trueserve/reflowOvenController/hardware/doc/ZC-schema.gif

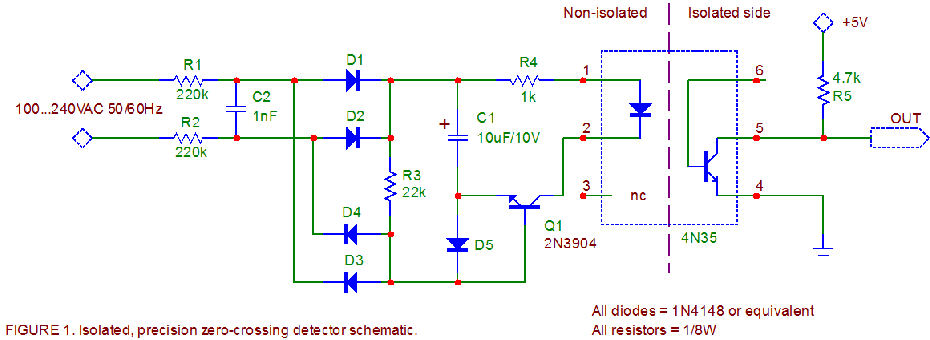
hardware/doc/ZC-schema.gif
