trueserve/reflowOvenController/hardware/ReflowController_kp.v0.2.brd.preview.png

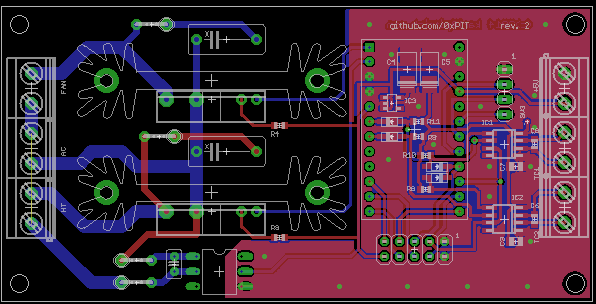
hardware/ReflowController_kp.v0.2.brd.preview.png
