trueserve/reflowOvenController/hardware/ReflowController_kp.v0.2.sch.preview.png

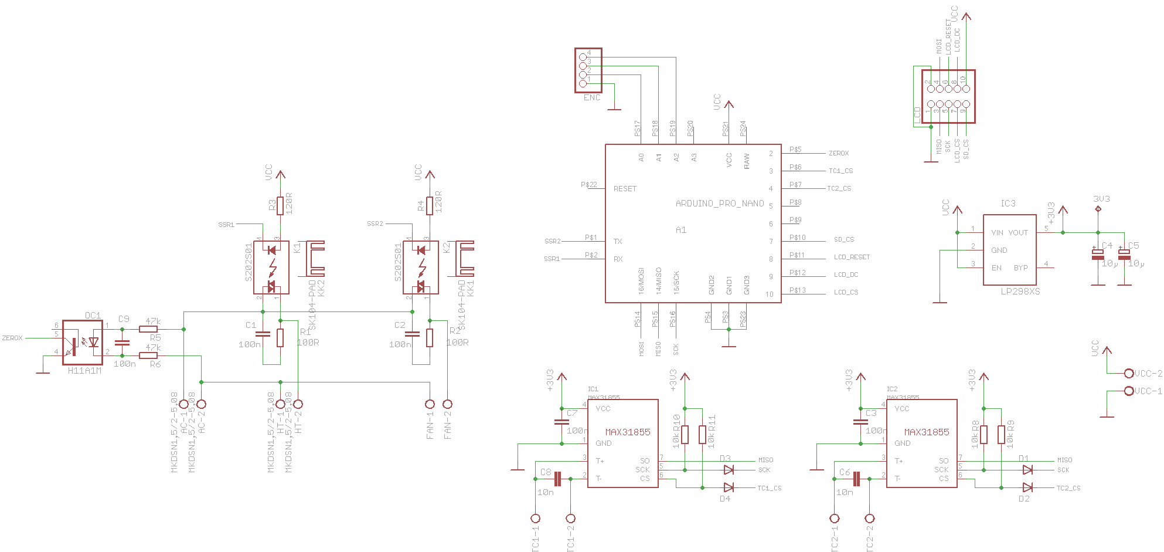
hardware/ReflowController_kp.v0.2.sch.preview.png
