trueserve/reflowOvenController/hardware/ReflowController_kp.brd

## EAGLE design hardware/ReflowController_kp.brd (2014-10-26)

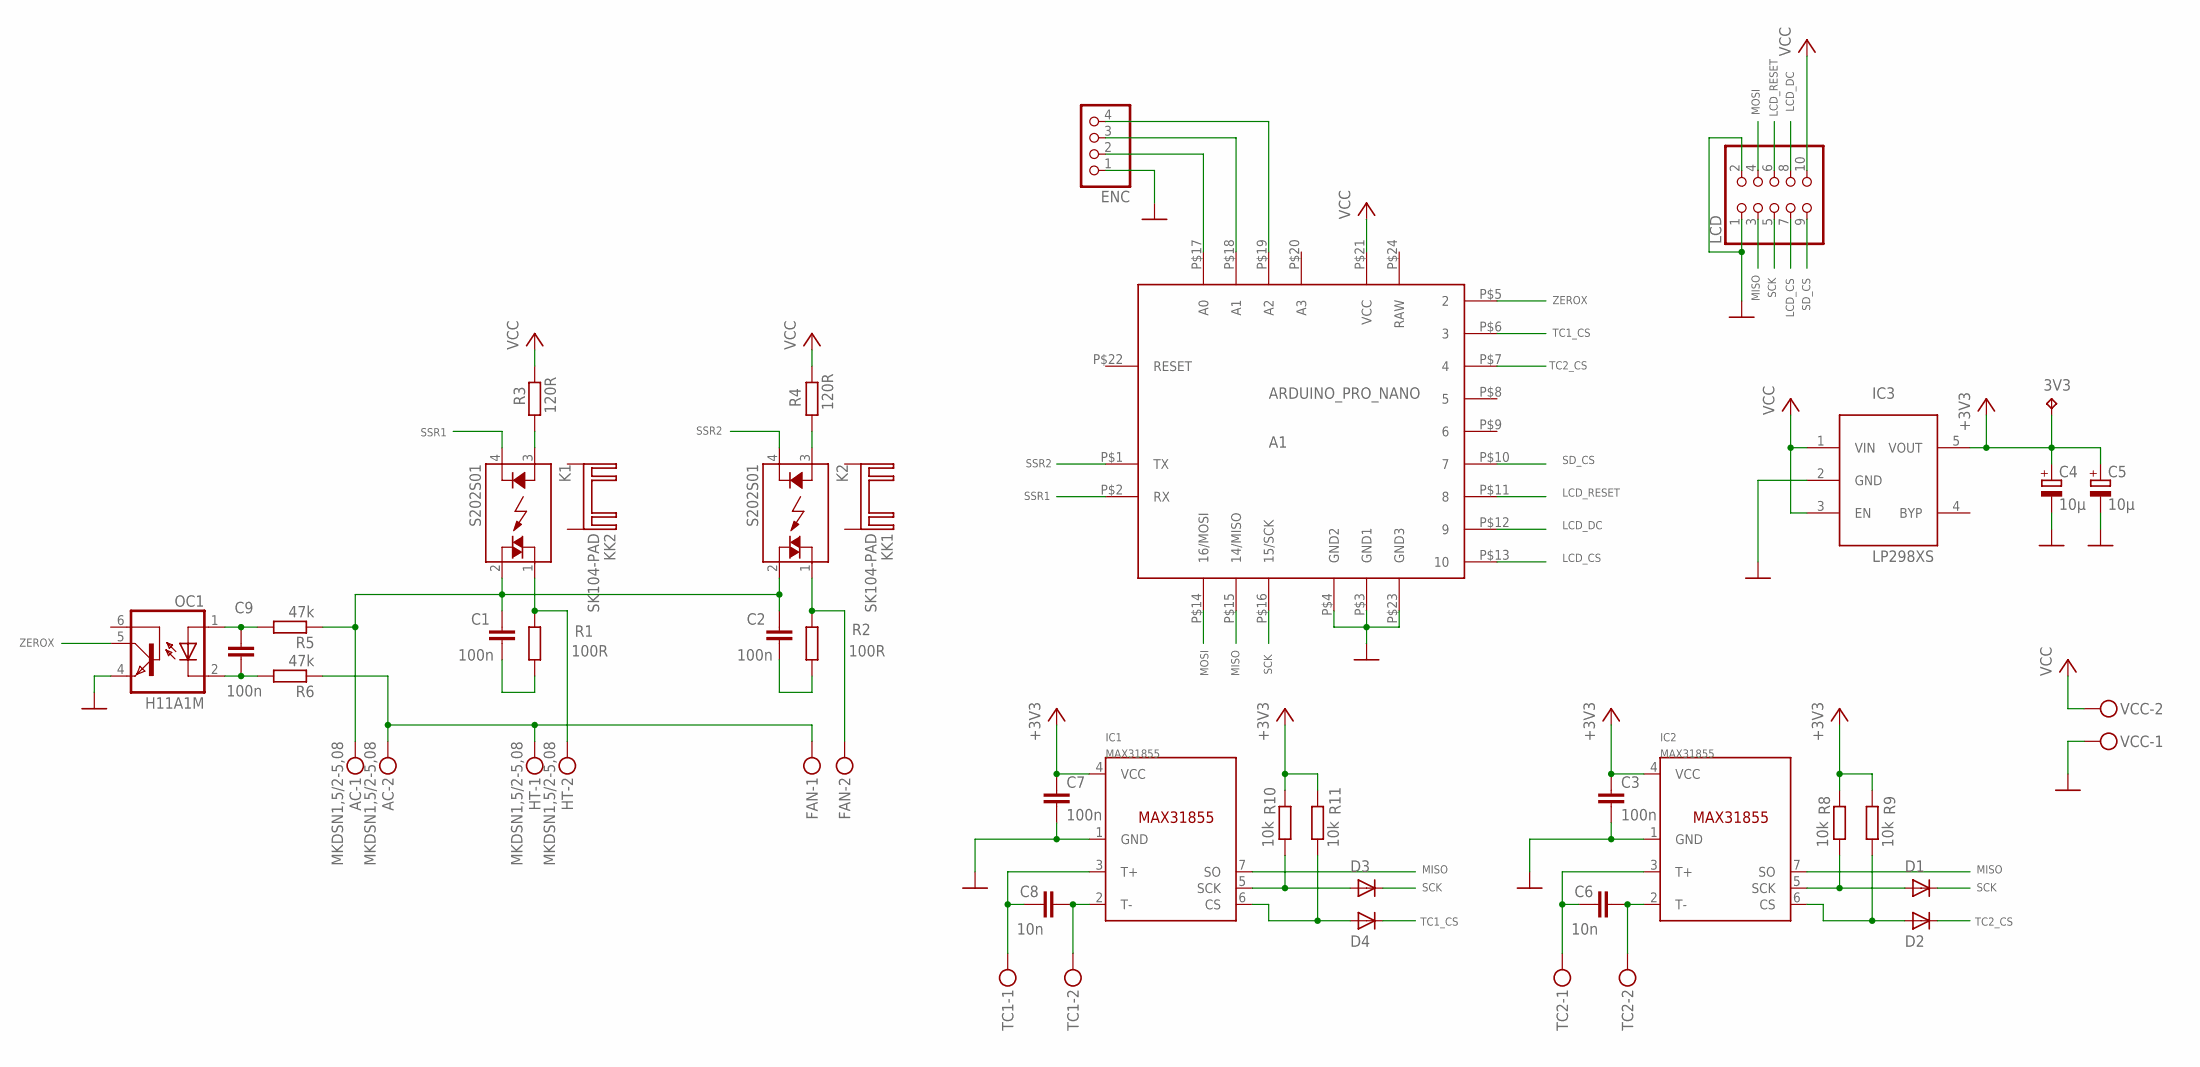
[picture p6: schematic ReflowController_kp.sch]

Parts:
3V3: TPTP08R; TP08R
A1: ARDUINO_PRO_NANO
AC: MKDSN1,5/2-5,08
C1, C2: 100n; XC10B5
C3, C7: 100n; C0805
C4, C5: 10µ; C/6032-28R
C6, C8: 10n; C0603
C9: 100n; C025-025X050
D1, D2, D3, D4: DIODESOD-123; SOD-123
ENC: PINHD-1X4; 1X04
FAN: MKDSN1,5/2-5,08
HT: MKDSN1,5/2-5,08
IC1, IC2: MAX31855; SOIC8
IC3: LP298XS; SOT23-5L
K1, K2: S202S01; S102S01
KK1, KK2: SK104-PAD
LCD: PINHD-2X5; 2X05
OC1: H11A1M; DIL06
R1, R2: 100R; 0207/5V
R3, R4: 120R; R0603
R5, R6: 47k; 0207/5V
R8, R9, R10, R11: 10k; R0603
TC1, TC2: MKDSN1,5/2-5,08
VCC: MKDSN1,5/2-5,08

Connections:
+3V3: 3V3.TP, C3.1, C4.+, C5.+, C7.1, IC1.4 (VCC), IC2.4 (VCC), IC3.5 (VOUT), R8.2, R9.2, R10.2, R11.2
AC1: AC.1, C1.1, C2.1, K1.2 (DS2), K2.2 (DS2), R5.1
AC2: AC.2, FAN.1, HT.1, R6.1
AC_OUT1: HT.2, K1.1 (DS1), R1.2
AC_OUT2: FAN.2, K2.1 (DS1), R2.2
GND: A1.P$3 (GND1), A1.P$4 (GND2), A1.P$23 (GND3), C3.2, C4.-, C5.-, C7.2, ENC.1, IC1.1 (GND), IC2.1 (GND), IC3.2 (GND), LCD.1, LCD.2, OC1.4 (EMI), VCC.1
LCD_CS: A1.P$13 (10), LCD.7
LCD_DC: A1.P$12 (9), LCD.8
LCD_RESET: A1.P$11 (8), LCD.6
MISO: A1.P$15 (14/MISO), IC1.7 (SO), IC2.7 (SO), LCD.3
MOSI: A1.P$14 (16/MOSI), LCD.4
unnamed: C8.2, IC1.2 (T-), TC1.2
unnamed: C6.2, IC2.2 (T-), TC2.2
unnamed: C6.1, IC2.3 (T+), TC2.1
unnamed: A1.P$17 (A0), ENC.2
unnamed: A1.P$18 (A1), ENC.3
unnamed: C1.2, R1.1
unnamed: C2.2, R2.1
unnamed: A1.P$19 (A2), ENC.4
unnamed: C9.1, OC1.1 (A), R5.2
unnamed: C9.2, OC1.2 (C), R6.2
unnamed: C8.1, IC1.3 (T+), TC1.1
unnamed: K1.3 (A), R3.2
unnamed: K2.3 (A), R4.2
unnamed: D2.A, IC2.6 (CS), R9.1
unnamed: D1.A, IC2.5 (SCK), R8.1
unnamed: D4.A, IC1.6 (CS), R11.1
unnamed: D3.A, IC1.5 (SCK), R10.1
RAW: A1.P$24 (RAW)
SCK: A1.P$16 (15/SCK), D1.C, D3.C, LCD.5
SD_CS: A1.P$10 (7), LCD.9
SSR1: A1.P$2 (RX), K1.4 (K)
SSR2: A1.P$1 (TX), K2.4 (K)
TC1_CS: A1.P$6 (3), D4.C
TC2_CS: A1.P$7 (4), D2.C
VCC: A1.P$21 (VCC), IC3.1 (VIN), IC3.3 (EN), LCD.10, R3.1, R4.1, VCC.2
ZEROX: A1.P$5 (2), OC1.5 (COL)

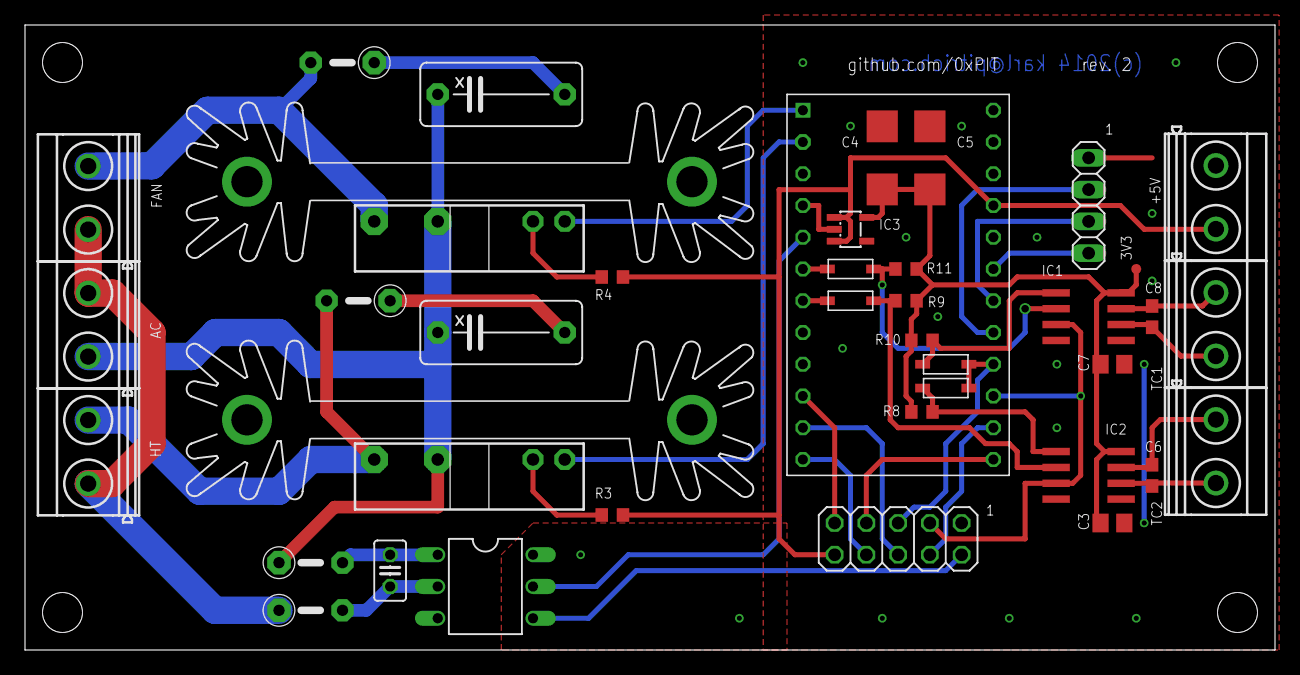
[picture p7: board ReflowController_kp.brd from above]

Board: 2 copper layers, 100.0 x 50.0 mm, 41 parts (0 on the bottom side), 36 nets.
