trueserve/reflowOvenController/(commit log)

2014-10-25 Rename ReflowController.pde to ReflowController.ino
    Using extension Arduino 1.5.x GUI expects to see.
2014-10-25 Initial minor cleanup, clarification
    - Began cleaning up parts of the code and organizing sections to make it
    easier to read, no actual changes performed
    - Added ARDUINO_TYPE and BOARD_TYPE preprocessor options to configure
    the code to the target
2014-10-25 Add compile-time LCD rotation setting, usability fixes
    - Adds rotation support for LCD, and fixes text and graphics to make
    this happen
    - Adds define for rotary encoder steps at top of file
    - Fixed bug of redefine of LCD_CS in temperature.h
    - Menu items are the correct width in either rotation; editing
    - Improved splash screen, though flash size is bigger as a result
    [ReflowController.ino, temperature.h]
2014-10-25 Register accesses changed to Arduinoisms (portability), more clarifications
    - Minor formatting updates to fix inconsistencies and make code match
    the original programming style
    - Moved LCD physical configuration defines out of the user configurable
    area; these are set by the compile time user-configurable LCD rotation
    - Made any direct port register code no longer directly access the port
    direction and output registers. Code should be fully portable between
    nano/mini and micro now, I hope...
    - Updated todo list based on findings so far in code and needs of
    current application
    [ReflowController.ino]
2014-10-26 hardware/ directory cleanup
    - Cleaned up kp's design files and documents
    - Removed kp's board house DRU, added ignore for .dru
    [ReflowController_kp.brd, ReflowController_kp.sch, ReflowController_kp_bom.csv, bom.csv]
2014-10-26 true's Reflow Controller PCB+Schematic
    My version of the Reflow Controller.
    This is REV2, untested. I have mostly tested REV1 so far. Yes, it is way
    more complicated than the original. :)
    - Schematic cleaned up and organized. Hopefully this is easier to read
    now.
    - Supports physically Arduino Pro Mini, Pro Micro or Nano V3.0
    - No built in SSR's - this version is intended for 120V, and external
    SSRs supporting the current needed for 1500W ovens are cheaper anyway.
    Also allows for other options for output. This also means that the FAN
    and HTR AC ports are just paralleled with AC IN; they don't need to be
    used.
    - As there are no built-in SSRs, the board is shorter by 2cm
    - Header and connecto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
    [ReflowController_true_rev2.brd, ReflowController_true_rev2.sch]
2014-10-26 Update .gitignore
    Ignore gerbers
2014-10-26 Simplify pin output control on heater, fan channels
    Since we're hardcoded to two different methods of control for the heater
    and fan, and there is no loop, there's no reason we can't just use the
    pins for the heater and fan directly. So I do this now. Saves >150bytes.
2014-10-26 Fix profile load/save can't exit; Made reset harder
    - Fixes the bug where you can't cancel loading or saving a profile, or
    cancel factory resetting
    - Makes factory resetting more difficult by requiring a double-click to
    confirm
    [ReflowController.ino]
2014-10-26 Fix double-click on root items clears the screen
    I made this bug in 425764eb29, oops
    [ReflowController.ino]
2014-10-26 TimerThree replaced with Timer2, fake_hw fixes
    Arduino Mini and Nano does not have TimerThree.
    Using Timer2 for fake hardware support.
    Fixed various issues when running in FAKE_HW mode. Saved space where
    possible in FAKE_HW mode to make room to put other things in to test.
    Hardware startup order changed to make more sense.
    Double-clicking on not previously activated Factory Reset option will no
    longer factory reset the device.
    Saved 6 bytes of flash in mainline.
    [ReflowController.ino]
2014-10-26 Re-added Timer3 for Micro, removed ARDUINO_TYPE
    TimerThree was re-added since the Micro doesn't have Timer2. However,
    TimerThree has a bug where it doesn't check to see if the processor is
    capable, and either Arduino or the compiler is too stupid to see that
    this isn't included anymore after the preprocessor, so either comment
    the include out or modify TimerThree to check this.
    Removed ARDUINO_TYPE and perform tasks depending on the type of
    processor.
2014-10-26 Fixed time elapsed for 60Hz systems
    The time counter was set at fixed 100Hz ZX; this is now computed based
    on LINE_FREQ and now has a proper time elapsed counter.
    Timer2 and TimerThree stuff was changed / fixed so this works as
    expected in FAKE_HW mode.
    [ReflowController.ino]
2014-10-26 Fix bottom status bar being cut off
    [ReflowController.ino]
2014-10-27 Optional support to store text strings in Flash
    RAM likely won't run short on this project, but a macro has been added
    wrapping all text, which as an example can be used as the Arduino F(x)
    macro.
    Also changed idleTemp to a defined value; this saved ~50bytes of Flash.
    TFT_ defines are now LCD_ defines.
    Need to look into why space is a consistent ~70 bytes higher when using
    PROGMEM; the lack of variables in .bss should reduce this size, should
    it not?
    [ReflowController.ino]
2014-10-27 Fixed garbage when editing digits of variable size
    If the amount of digits changed when editing something, such as fan
    speed, garbage would be left behind. Smallest hack I could find just
    prints some spaces at the end.
    [ReflowController.ino]
2014-10-27 Remove stale edit / information text, update todo.txt
    After editing an item (fan speed, PID values, etc) the informational
    text would be left behind on the bottom of the screen. I fix this by
    drawing a rectangle.
    Adding this code saved 82 bytes of space, I need to know why.
    Updated todo.txt with completed tasks marked off, more tasks to complete
    added
    [ReflowController.ino]
2014-10-27 Fix bad click to exit description
    When editing in a submenu, if you double-click to attempt to exit, it
    does so but one would assume the change wouldn't save. The editing
    applies all changes immediately so this isn't the case. Reworked the
    menus to not show this text.
    [ReflowController.ino]
2014-10-28 Added printCentered and printAtPos functions
    Most text is either centered, or has a setCursor call right before
    printing. Optimized this code a bit by functionalizing it. Saves
    >200bytes flash.
2014-10-29 Fixed submenu scrolling turning exit text blue
    [ReflowController.ino]
2014-10-29 Show profile ID; fix load profile shows wrong ID
    [ReflowController.ino]
2014-10-29 Using <avr/eeprom.h> over EEPROM.h
    The code already makes use of <avr/eeprom.h> so why not use it
    everywhere? Simplifies code a bit, and I would like to use eeprom_*_word
    so here is the change. Saves ~40 bytes.
    Changed the location of various variables to the end of EEPROM rather
    than right after the profiles. If the profile count changes in firmware,
    it won't put garbage in these variables anymore.
    [ReflowController.ino]
2014-10-29 Clarified new EEPROM offsets, new profile defaults
    The old offsets were pretty shit; hopefully these are clearer. Gaps are
    for future options I still need to implement though it really doesn't
    matter where they go.
    Set the profile defaults to what I will be using during development.
    Saved 6 bytes removing heaterPID startup values that aren't used.
    [ReflowController.ino]
2014-10-29 Removed per-profile checksum; added global checksum
    This project doesn't need per-profile checksums. Implemented a global
    checksum to verify data, and if not valid, reset all data.
    Changed function definition formatting to be consistent.
    [ReflowController.ino]
2014-10-29 Board: Fixed C7 mains cap size
    Changed C7 cap to a standard 15mm width X2 cap. Reworked the board in
    this area to get it to fit.
    [ReflowController_true_rev2.brd, ReflowController_true_rev2.sch]
2014-11-02 Fixed missed thermocouple variable names
    [ReflowController.ino]
2014-11-02 Changed PIDTune fixed variables to #defines
    Some values did not need to be variables, so have been changed to save
    space.
    [ReflowController.ino]
2014-11-02 Simplified getItemValuePointer, rampRate now int16_t
    getItemValuePointer was used to recall various values for display and
    editing. It did so by updating indirect ptr for a double and an int16.
    The function was changed instead to return pointer to type void, which
    simplifies use and lets any time be used where necessary.
    rampUpRate and rampDownRate are now int16_t and are stored as tenths of
    a degree. The overhead for doing math to print these for editing is less
    than the FP math necessary to work with them. int16_t is used as other
    printing functions already use this type, so this saves space.
    Additionally, lower bounds checking is in place for editing numbers - no
    number in practice goes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
2014-11-02 timerIsr tick rate reduced from 10KHz to 4KHz
    For this slow MCU, a 10KHz timer ISR is just too fast - context switch /
    ISR to code execute time is pretty big on AVR so this ISR was stealing a
    lot of time just being alive. From what I can tell changing this to 4KHz
    won't really hurt anything but will improve responsiveness of the menus.
    Save 6 bytes by changing when encoder is serviced in this interrupt.
    [ReflowController.ino]
2014-11-02 timerIsr tick reduced more, divisble with line freq
    Changed timerIsr tick to be evenly divisible with line frequency of 50Hz
    or 60Hz. This further reduces the tick rate from 4KHz to 1666Hz.
    At this frequency, UI is a lot more responsive. Knob polling has been
    changed to every timerIsr firing (with slight code size reduction).
    ClickEncoder is modified slightly to allow adjusting values based on
    this new tickrate, and these values are in this main source file.
    Changed process run screen update to update the screen more smoothly
    with these settings. Setpoint changes smoothly, no more jumping around.
    DEFAULT_LOOP_DELAY was fucked last time, I think. Now it is now
    calculated from the cycle tim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
2014-11-02 Stop rendering the graph after process completes
    After the process completes, the graph code will proceed to loop around
    and print a cooled down oven line. This doesn't look good. Added option
    to stop rendering the graph as soon as we hit the Completed step.
    NOTE: This version will stop rendering everything, including
    temperature. A future version will render the current temperature when
    done.
    [ReflowController.ino]
2014-11-02 Continue updating temp when not updating graph
    Shows current oven temperature after Complete phase, which is what it
    should have done after my last change.
2014-11-02 Fix text size is wrong after complete phase
    Once the process completes, text size is stuck large, so exiting to the
    menu prints unusable items. Oops.
    [ReflowController.ino]
2014-11-03 Fixed elapsed time not showing after complete phase
    Wow, I missed a lot on this. If a completion has occurred, then the next
    cycle wouldn't have a timer. Fixed and also clarified the variable name.
    [ReflowController.ino]
2014-11-03 Show temps on graph lines, related bugfixes
    Added code to show temperatures on the graph lines, on the right-hand
    side of the graph.
    Wrote the number of bytes required to use each graph option alone.
    Removed all use of Color565() and replaced with #define'd values. Saves
    72 bytes.
    Fixed bug in stop graph on done code that failed compilation of the
    option was disabled.
    [ReflowController.ino]
2014-11-03 Minor optimizations
    Low hanging fruit by optimizing type sizes.
    Fixed some flash-related stuff that could save SRAM if ever needed in
    the future.
    [ReflowController.ino]
2014-11-03 Added menu area separator, neatened landscape view
    Added a horizontal separator to separate the menu from the lower area. I
    plan to do things in the lower area, and it also helps to visually
    identify that there may be more than 5 things in the menu.
    Darkened the bottom bar in the graph to separate the graph from the
    heater/fan/rate status info.
