trueserve/reflowOvenController/(notices)

Notices in the files:
hardware/ReflowController_kp.brd:
(c)2014 karl@pitrich.com
